phacb/multilev/images/MultiLev.JPG

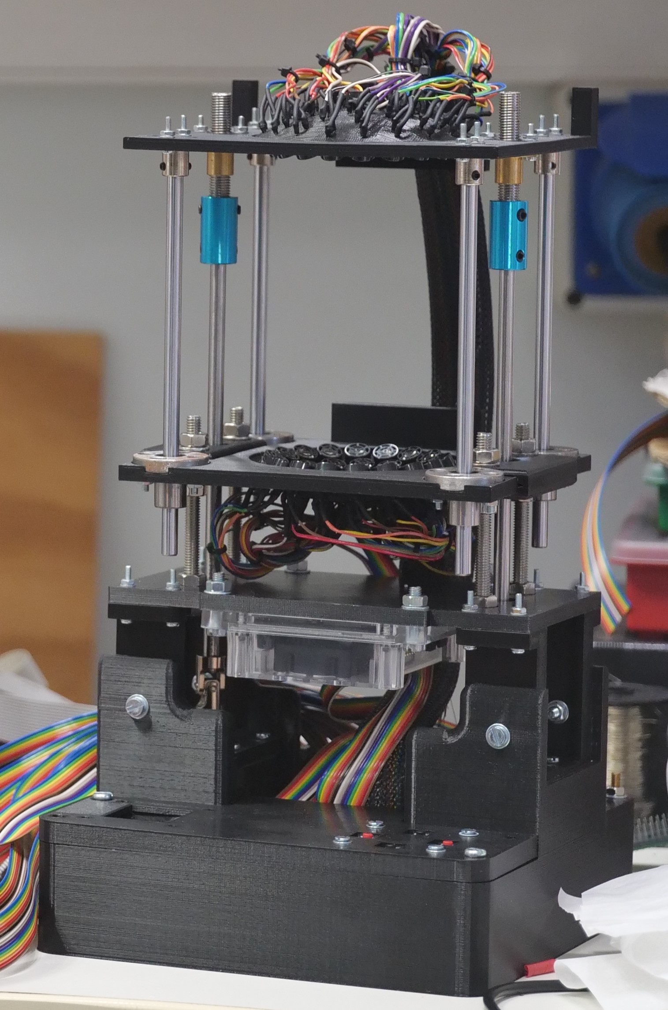
images/MultiLev.JPG
