phacb/multilev/README.md

# multilev
A hardware and software solution for driving acoustic levitator transducers independently for manipulation and control. It uses multiply connected Raspberry Pi Picos in a master/slave configuration. Schematics and gerber files for a suitable driving board are also given.
