phacb/multilev/driver board/README.md

#### This folder contains the Gerber files required for manufacture of the printed circuit board (pcb) for the MOSFET driver circuit
