phacb/multilev/code/README.md

This folder contains the python and micropython code for the pi-pico multi-channel signal generator for multiLev

master.py - micropython code to run on master pico
slave.py  - micropython code to run on slave picos

Note. These should be used with micropython 1.22 for the pi pico
Note. The code in slave.py is written to obtain a hardware address for the slave on GPIO26-GPIO28
