phacb/multilev/multiLev_design_files/MultiLev.pdf

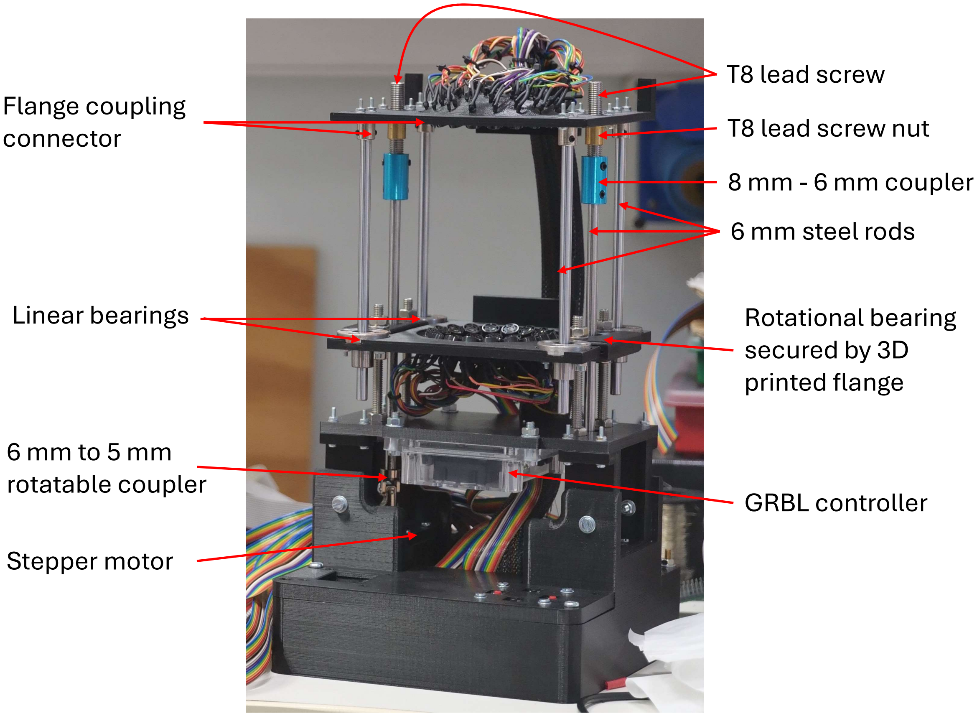
[picture p3: page 1]

T8 lead screw
T8 lead screw nut

### 8 mm - 6 mm coupler 6 mm steel rods

Flange coupling
connector
Linear bearings | Rotational bearing secured by 3D printed flange

### 6 mm to 5 mm

rotatable coupler Stepper motor | GRBL controller
