phacb/multilev/multiLev_design_files/multi_phase_control/phase_array_data.xlsx

Sheet: Sheet1
old GPIO | GPIO | Phases
46 | 36 | 1.8786192 | 1.9244194 | 1.9664232 | 0.0045957565 | 0.03890705 | 0.06932926 | 0.09583473 | 0.11840153 | 0.13701248 | 0.15164852 | 0.16229916 | 0.1689539 | 0.17160891 | 0.17026043 | 0.16490935 | 0.1555605 | 0.1422224 | 0.12490654 | 0.10362816 | 0.07840443 | 0.04925728 | 0.01621151 | 1.9792948 | 1.9385366 | 1.8939704 | 1.8456335
23 | 3 | 1.8818245 | 1.9276344 | 1.9696474 | 0.007829666 | 0.04214859 | 0.07257748 | 0.09908962 | 0.12166214 | 0.14027691 | 0.15491676 | 0.16557024 | 0.17222595 | 0.17488098 | 0.17353249 | 0.16818047 | 0.15882969 | 0.14548874 | 0.12816906 | 0.10688496 | 0.08165551 | 0.05250168 | 0.019447327 | 1.982522 | 1.9417542 | 1.8971786 | 1.8488312
47 | 41 | 1.8796835 | 1.9016733 | 1.9197634 | 1.933942 | 1.9441938 | 1.9505129 | 1.9528933 | 1.951332 | 1.9458313 | 1.9363967 | 1.9230338 | 1.905754 | 1.8845739 | 1.8595096 | 1.8305817 | 1.7978144 | 1.7612344 | 1.720869 | 1.6767521 | 1.6289167 | 1.577403 | 1.5222464 | 1.4634905 | 1.4011793 | 1.3353548 | 1.2660694
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
