phacb/multilev/multiLev_design_files/stl files/gantry_base.stl

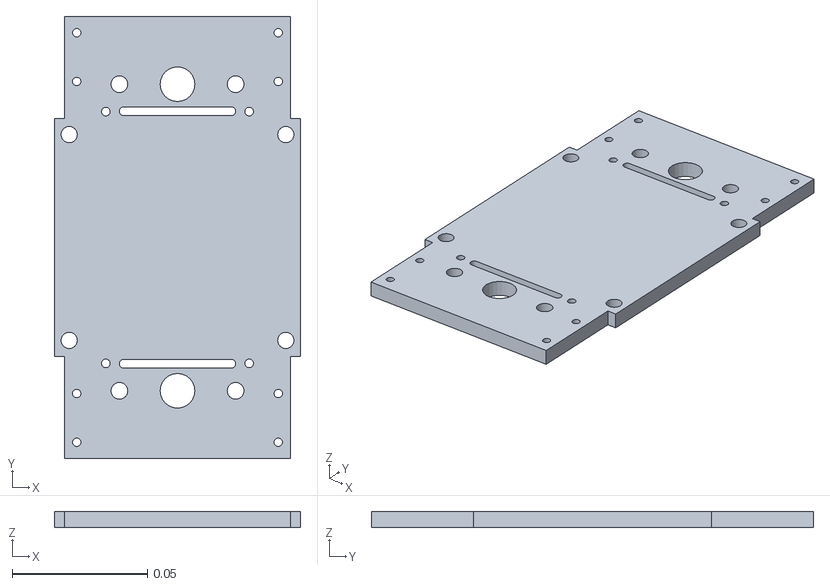
[picture p5: CAD file, 2026-08-22]
multiLev_design_files/stl files/gantry_base.stl
0.0909 x 0.163 x 0.006
