phacb/multilev/multiLev_design_files/stl files/flange.stl

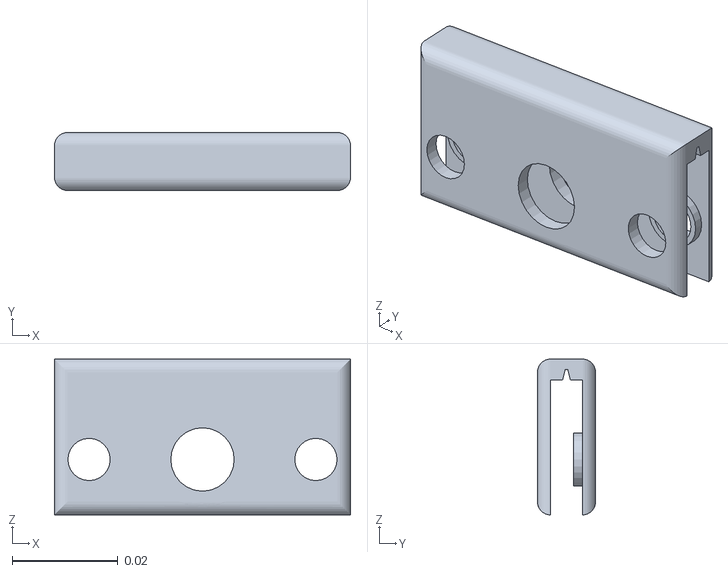
[picture p6: CAD file, 2026-08-22]
multiLev_design_files/stl files/flange.stl
0.056 x 0.011 x 0.0295
