phacb/multilev/multiLev_design_files/stl files/mosfet-plate.stl

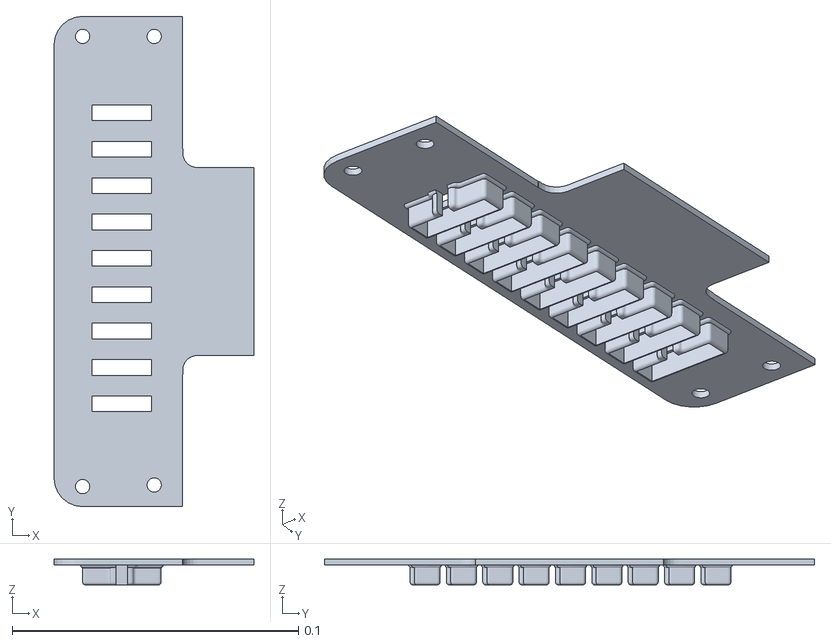
[picture p7: CAD file, 2026-08-22]
multiLev_design_files/stl files/mosfet-plate.stl
0.0698 x 0.171 x 0.00904
