phacb/multilev/multiLev_design_files/stl files/top-array.stl

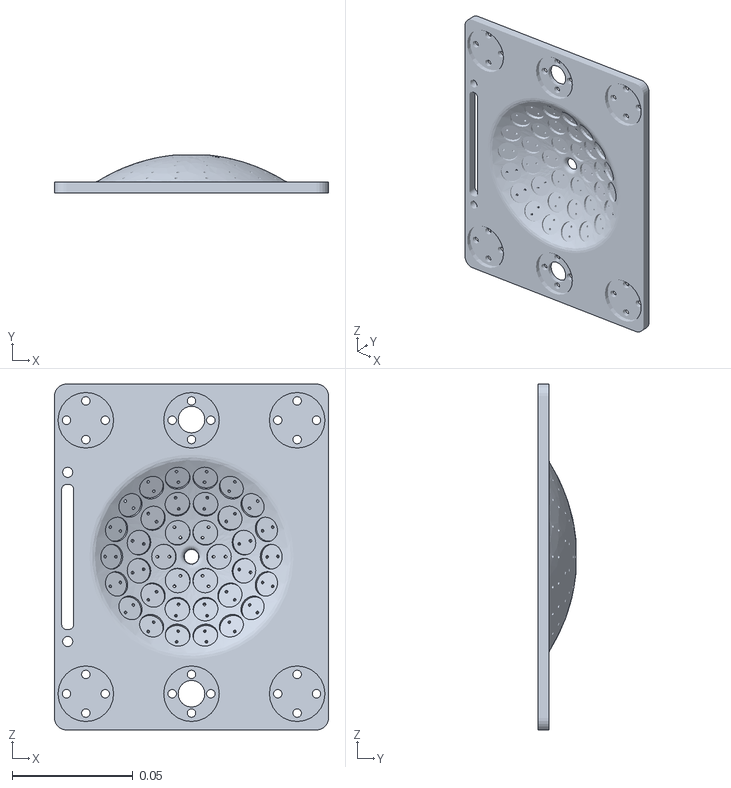
[picture p8: CAD file, 2026-08-22]
multiLev_design_files/stl files/top-array.stl
0.113 x 0.0158 x 0.143
