phacb/multilev/multiLev_design_files/stl files/gantry.stl

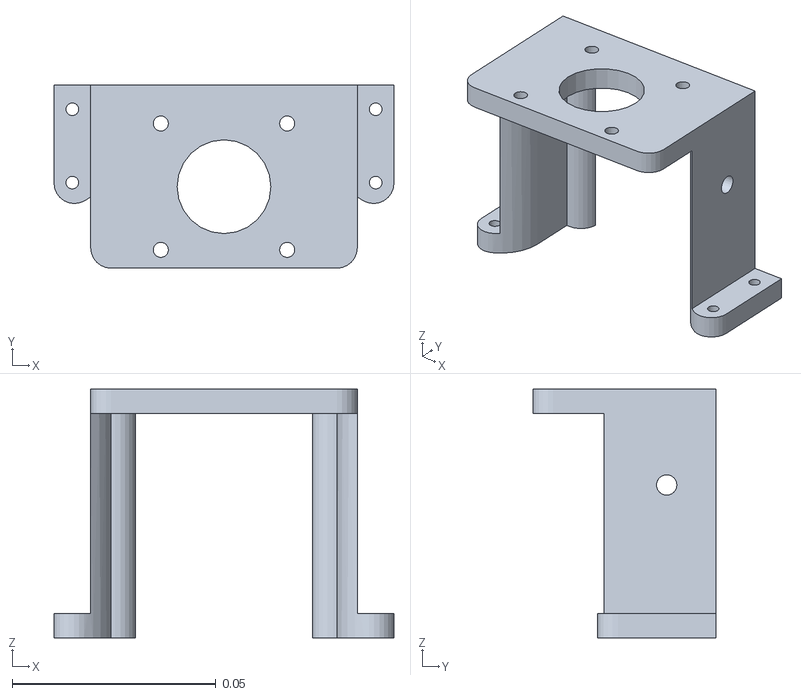
[picture p9: CAD file, 2026-08-22]
multiLev_design_files/stl files/gantry.stl
0.0834 x 0.045 x 0.061
