phacb/multilev/multiLev_design_files/stl files/bottom-array.stl

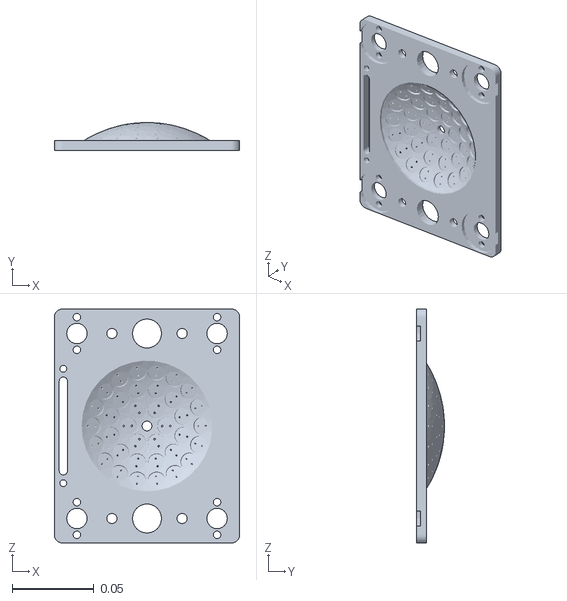
[picture p10: CAD file, 2026-08-22]
multiLev_design_files/stl files/bottom-array.stl
0.113 x 0.017 x 0.143
