phacb/multilev/multiLev_design_files/stl files/base.stl

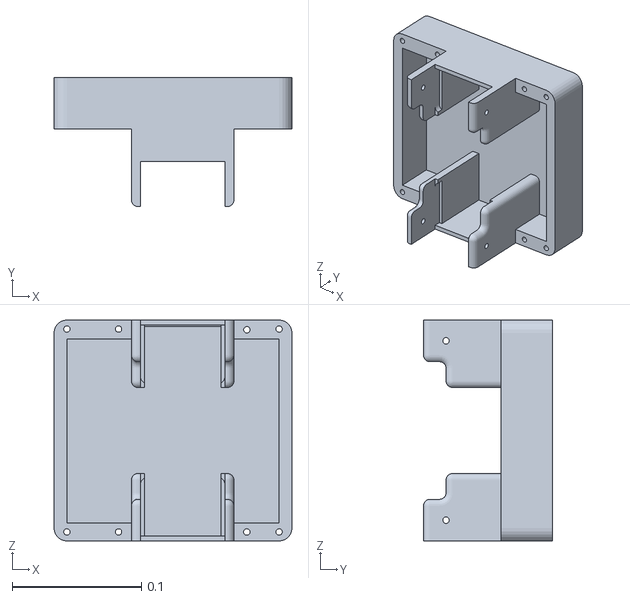
[picture p11: CAD file, 2026-08-22]
multiLev_design_files/stl files/base.stl
0.184 x 0.1 x 0.171
