phacb/multilev/multiLev_design_files/stl files/mosfet-plate-bottom.stl

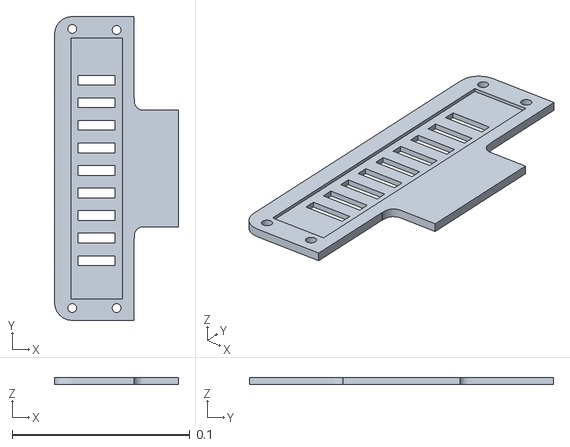
[picture p12: CAD file, 2026-08-22]
multiLev_design_files/stl files/mosfet-plate-bottom.stl
0.0698 x 0.171 x 0.004
