phacb/multilev/(commit log)

2026-08-21 Rename driver board/1708010590-tc4428_8chip_gerberfiles.zip to tc4428_8chip_driver_gerberfiles.zip
    This zip files contains the gerber files for making the TC4428 drivre board
2026-08-21 Rename tc4428_8chip_driver_gerberfiles.zip to driver board/tc4428_8chip_driver_gerberfiles.zip
2026-08-22 Add MultiLev design files
    [base.stl, bottom-array.stl, flange.stl, gantry.stl, gantry_base.stl, mosfet-plate-bottom.stl, mosfet-plate.stl, top-array.stl]
2026-08-22 add phase data files
    [phase_array_data.xlsx]
2026-08-22 rename directory
    [base.stl, bottom-array.stl, flange.stl, gantry.stl, gantry_base.stl, mosfet-plate-bottom.stl, mosfet-plate.stl, phase_array_data.xlsx]
