phacb/multilev/images/MultiLev-front.jpg

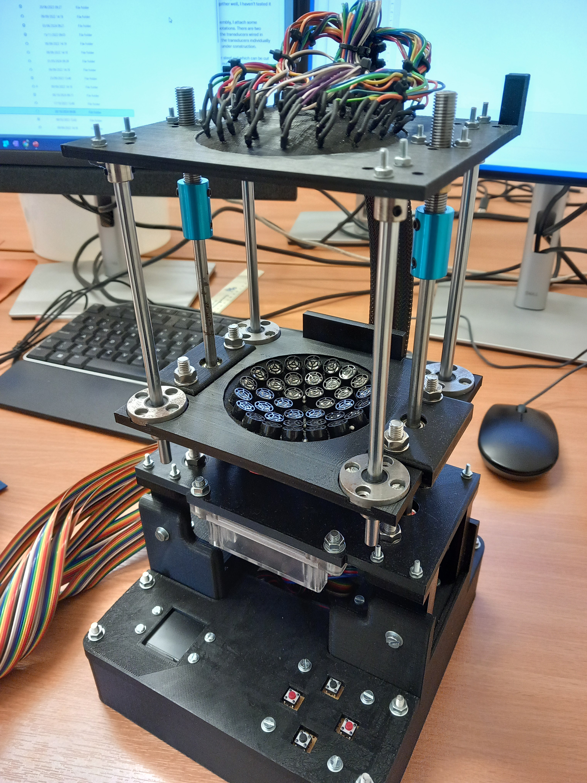
images/MultiLev-front.jpg
