phacb/multilev/images/MultiLev-back.jpg

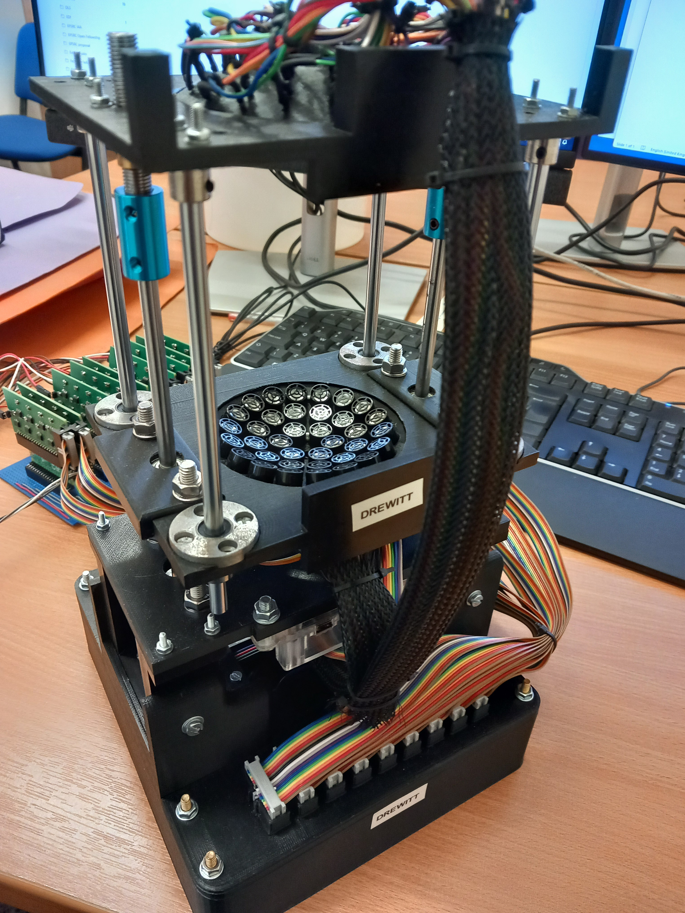
images/MultiLev-back.jpg
